skpatel6/Pelvic-Floor-Muscle-Biofeedback-Games/Documents/Progress Reports/BME_Weekly_Report_11-13.pdf

Pelvic floor Biofeedback Design

Client: Dr. Patrick McKenna, UW Urology Department

Advisor: Dr. Amit Nimunkar

Team: Sam Lines (Leader)

Michael Simonson (Communicator)

Shawn Patel (BWIG)

Andrew Vamos (BSAC&BPAG)

Date: 11/6/2014-11/14/2014

### Problem Statement

Pelvic floor muscle biofeedback systems have been used to educate and train people how to correctly control the process of urination in children and elderly patients. As devices slowly fail or get outdated, a new device and interface system that can be used in conjecture with videogame like training programs is desired. With the completion of a basic EMG biofeedback system, our goal is to continue to improve the functionality of the software while simultaneously designing hardware with commercial standards in mind. This product will be designed and tested so that use in a hospital will be safe for both the hospital staff and the patients.

### Last Week’s Goals

- Upon our final review of the PCB, we will order it along with the parts needed to start version two of the EMG system.
- We will continue to work on the IRB proposal to be able to submit it as soon as possible.
- Along with the IRB proposal submission, work in tandem with Dr. McKenna to ensure everyone has the proper training for human subject testing

### Summary of Team Role Accomplishments

- Leader (Sam): Finalized the PCB with Shawn
- Communicator (Michael): Continued IRB work
- BWIG (Shawn): Finalized the PCB with Sam
- BPAG And BSAC(Andrew): Began research into Arduino coding

### Summary of Design Accomplishments

- After running into an unforeseen problem with the PCB, we have now completed the PCB, and are reviewing it
- Due to the delay in the PCB, we plan to order the parts and PCB today or tomorrow.
- Andrew made some good progress into the Arduino coding research, and we believe it we will be able to quickly finalize version one of the EMG pending no further set backs

### Project Difficulties

- A last minute catch in the PCB made it so we had to push back the ordering of the PCB for a little over a week. Now that we have finished with the PCB, we will try to make up ground on neglected areas of the project
- Since we are a little behind again, we will have to work very diligently in the coming weeks to prevent costly mistakes. We hope to be testing our device before Thanksgiving break assuming the parts come in.

### This Week’s Goals

- After dealing with a PCB problem, we are ready to order that and the second parts list. •

### Activities

Person(s) | Task | Time (hrs) | Week Total | Semester Total
Sam | PCB work Team meeting | 2.5 2.5 | 5 | 33
Michael | IRB Team meeting | 2.5 2.5 | 5 | 33
Shawn | PCB Work Team meeting | 2.5 2.5 | 5 | 33
Andrew | Aduino Code Team meeting | 2.5 2.5 | 5 | 33

### Timetable

- Due to the large size of our timeline, I will attach the full excel spreadsheet

### Expenses

- After buying the parts, the current expense of the project is $41.22. A picture of the total expenses incurred is posted below.

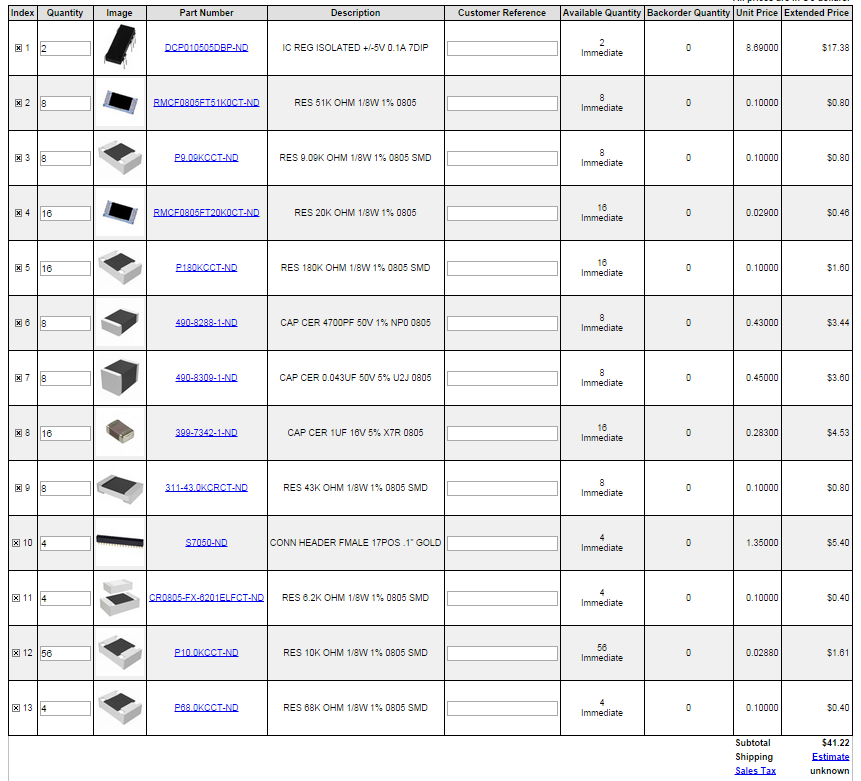
[picture p12: figure]
