skpatel6/Pelvic-Floor-Muscle-Biofeedback-Games/Documents/Progress Reports/BME_Weekly_Report_11-20.pdf

Pelvic floor Biofeedback Design

Client: Dr. Patrick McKenna, UW Urology Department

Advisor: Dr. Amit Nimunkar

Team: Sam Lines (Leader)

Michael Simonson (Communicator)

Shawn Patel (BWIG)

Andrew Vamos (BSAC&BPAG)

Date: 11/17/2014-11/21/2014

### Problem Statement

Pelvic floor muscle biofeedback systems have been used to educate and train people how to correctly control the process of urination in children and elderly patients. As devices slowly fail or get outdated, a new device and interface system that can be used in conjecture with videogame like training programs is desired. With the completion of a basic EMG biofeedback system, our goal is to continue to improve the functionality of the software while simultaneously designing hardware with commercial standards in mind. This product will be designed and tested so that use in a hospital will be safe for both the hospital staff and the patients.

### Last Week’s Goals

- Order the PCB and second round of parts
- We will continue to work on the IRB proposal to be able to submit it as soon as possible.
- Test the first round of parts to ensure that everything works properly

### Summary of Team Role Accomplishments

- Leader (Sam): Finalized the PCB with Shawn and tested first round of parts
- Communicator (Michael): Continued IRB work
- BWIG (Shawn): Finalized the PCB with Sam
- BPAG And BSAC(Andrew): continued research into Arduino coding

### Summary of Design Accomplishments

- We have ordered all of the parts that we will need to complete version one of our design and start working on version two.
- We continue to make progress on the IRB submission and we look forward to submitting it as soon as possible. Everyone in the group has taken the necessary CITI and HIPAA training.
- We have started to push the project from a design oriented phase to a more balanced phase in which we will make improvements on the design as well as pursuing formal documentation and possible submission to WARF.

### Project Difficulties

- Since we have ordered the parts and PCB, most of this week's work has involved working on the IRB submission and updating documents, and therefore we didn't run into any struggles worth reporting.

### This Week’s Goals

- While waiting for the second round of parts and the PCB, we will continue working on the IRB application
- We will start to make our documentation of the entire project more professional while waiting for the PCB
- Start working to implement the new microcontroller code, and test with our bread board EMGs
- Begin working on version two of the design which will be more suited to commercialization.

### Activities

Person(s) | Task | Time (hrs) | Week Total | Semester Total
Sam | PCB work Team meeting | 2.5 2.5 | 5 | 38
Michael | IRB Team meeting | 2.5 2.5 | 5 | 38
Shawn | PCB Work Team meeting | 2.5 2.5 | 5 | 38
Andrew | Aduino Code Team meeting | 2.5 2.5 | 5 | 38

### Timetable

- Due to the large size of our timeline, I will attach the full excel spreadsheet

### Expenses

- After buying the parts, the current expense of the project is $41.22. A picture of the total expenses incurred is posted below.
