skpatel6/Pelvic-Floor-Muscle-Biofeedback-Games/Documents/Progress Reports/BME_Weekly_Report_11-6.pdf

Pelvic floor Biofeedback Design

Client: Dr. Patrick McKenna, UW Urology Department

Advisor: Dr. Amit Nimunkar

Team: Sam Lines (Leader)

Michael Simonson (Communicator)

Shawn Patel (BWIG)

Andrew Vamos (BSAC&BPAG)

Date: 11/3/2014-11/6/2014

### Problem Statement

Pelvic floor muscle biofeedback systems have been used to educate and train people how to correctly control the process of urination in children and elderly patients. As devices slowly fail or get outdated, a new device and interface system that can be used in conjecture with videogame like training programs is desired. With the completion of a basic EMG biofeedback system, our goal is to continue to improve the functionality of the software while simultaneously designing hardware with commercial standards in mind. This product will be designed and tested so that use in a hospital will be safe for both the hospital staff and the patients.

### Last Week’s Goals

- Order the second set of parts that we forgot to order last time
- Finish the PCB and order that with the next parts
- Finish a testing protocol so that we can test the device as soon as it is made.

### Summary of Team Role Accomplishments

- Leader (Sam): Finalized the PCB with Shawn
- Communicator (Michael): Continued IRB work and finished work on lead fall off detection
- BWIG (Shawn): Finalized the PCB with Sam
- BPAG And BSAC(Andrew): Finished controllable gain work

### Summary of Design Accomplishments

- We have finished the PCB schematic and are ready to order it pending some final reviews and revisions
- We have decided to freeze our current work and pursue it as version one of the EMG system

- While we have frozen the design as is for version one, we have compiled a list of parts that will allow us to implement digitally controllable gain and lead fall off detection in version two.

### Project Difficulties

- With our research into controllable gain and lead off detection, we decided that in order to implement them into our first version it would significantly delay our ordering of the PCB.
- The remote access version of Altium provided through the university has limited libraries of parts provided, so it delayed our completion of the PCB a little more than we anticipated

### This Week’s Goals

- Upon our final review of the PCB, we will order it along with the parts needed to start version two of the EMG system.
- We will continue to work on the IRB proposal to be able to submit it as soon as possible.
- Along with the IRB proposal submission, work in tandem with Dr. McKenna to ensure everyone has the proper training for human subject testing

### Activities

Person(s) | Task | Time (hrs) | Week Total | Semester Total
Sam | PCB work Team meeting | 2 1 | 3 | 28
Michael | Lead fall off detection IRB Team meeting | 1 1 1 | 3 | 29
Shawn | PCB Work Team meeting | 2 1 | 3 | 28
Andrew | Controllable gain work Team meeting | 2 1 | 3 | 28

### Timetable

- Due to the large size of our timeline, I will attach the full excel spreadsheet

### Expenses

- After buying the parts, the current expense of the project is $41.22. A picture of the total expenses incurred is posted below.
