skpatel6/Pelvic-Floor-Muscle-Biofeedback-Games/Documents/Progress Reports/BME_Weekly_Report_10-30.pdf

Pelvic floor Biofeedback Design

Client: Dr. Patrick McKenna, UW Urology Department

Advisor: Dr. Amit Nimunkar

Team: Sam Lines (Leader)

Michael Simonson (Communicator)

Shawn Patel (BWIG)

Andrew Vamos (BSAC&BPAG)

Date: 10/27/2014-10/31/2014

### Problem Statement

Pelvic floor muscle biofeedback systems have been used to educate and train people how to correctly control the process of urination in children and elderly patients. As devices slowly fail or get outdated, a new device and interface system that can be used in conjecture with videogame like training programs is desired. With the completion of a basic EMG biofeedback system, our goal is to continue to improve the functionality of the software while simultaneously designing hardware with commercial standards in mind. This product will be designed and tested so that use in a hospital will be safe for both the hospital staff and the patients.

### Last Week’s Goals

- We have ordered the parts, so we will use the time for their delivery to finish the PCB and order that
- Begin working on the Arduino software to prepare to completion of the EMG circuit
- This software update will mainly consist of programmable gain control to help make the system more universal in patient treatment.

### Summary of Team Role Accomplishments

- Leader (Sam): Began work on the PCB schematic
- Communicator (Michael): Continued IRB work and started to work on lead fall off detection
- BWIG (Shawn): Implemented GitHub and started work on the gain control
- BPAG And BSAC(Andrew): Started working on microcontroller code formatting

### Summary of Design Accomplishments

- We have started to work on the PCB schematic and will have a first version finished early next week
- We forgot to order a few parts on our last order so we remade a list and will get that submitted as soon as we confirm we will have everything that we need.
- We will be meeting with Tina tomorrow to go over the IRB submission.

### Project Difficulties

- There have been some problems getting consistent power from the microcontroller so we will have to make our own USB port
- We have decided to incorporate lead fall off detection and controllable gain, so we will have to do some reading on how that can be coded into the Arduino.

### This Week’s Goals

- Order the second set of parts that we forgot to order last time
- Finish the PCB and order that with the next parts
- Finish a testing protocol so that we can test the device as soon as it is made.

### Activities

Person(s) | Task | Time (hrs) | Week Total | Semester Total
Sam | PCB work Team meeting | 2 1 | 3 | 25
Michael | Lead fall off detection Team meeting | 2 1 | 3 | 26
Shawn | Controllable gain Team meeting | 2 1 | 3 | 25
Andrew | Microcontroller coding work Team meeting | 2 1 | 3 | 25

### Timetable

- Due to the large size of our timeline, I will attach the full excel spreadsheet

### Expenses

- After buying the parts, the current expense of the project is $41.22. A picture of the total expenses incurred is posted below.
