skpatel6/Pelvic-Floor-Muscle-Biofeedback-Games/Documents/Progress Reports/BME_Weekly_Report_10-23.pdf

Pelvic floor Biofeedback Design

Client: Dr. Patrick McKenna, UW Urology Department

Advisor: Dr. Amit Nimunkar

Team: Sam Lines (Leader)

Michael Simonson (Communicator)

Shawn Patel (BWIG)

Andrew Vamos (BSAC&BPAG)

Date: 10/20/2014-10/25/2014

### Problem Statement

Pelvic floor muscle biofeedback systems have been used to educate and train people how to correctly control the process of urination in children and elderly patients. As devices slowly fail or get outdated, a new device and interface system that can be used in conjecture with videogame like training programs is desired. With the completion of a basic EMG biofeedback system, our goal is to continue to improve the functionality of the software while simultaneously designing hardware with commercial standards in mind. This product will be designed and tested so that use in a hospital will be safe for both the hospital staff and the patients.

### Last Week’s Goals

- Finalize our design on a printed circuit board hardware to order our PCB
- Look into the frequency characteristics of different muscle groups so that we can confirm that we are indeed measuring from the correct muscle groups
- Finalize testing protocols with Amit's guidance

### Summary of Team Role Accomplishments

- Leader (Sam): Communicated with professors of physiology and kinesiology to determine frequency characteristics of different muscles
- Communicator (Michael): Began contact with the IRB to prepare for clinical use
- BWIG (Shawn): Researched frequency characteristics of different muscles
- BPAG And BSAC(Andrew): Researched frequency characteristics of different muscles

### Summary of Design Accomplishments

- We have confirmed that the frequency components of the EMG signal will not help us differentiate signals from different muscles
- With that knowledge in mind, we ordered parts and will be working on ordering our pcb.
- Andrew found a paper describing the frequency changes at different levels of contraction that indicates it will be possible to use an envelope function to determine the amplitude of the signal, and then use that to play the game

### Project Difficulties

- In order to get the precision we wanted for our circuitry, we had to order surface mount components. Andrew has had some experience with this, so we don't believe it will be too much of an issue during construction
- Due to a grounding problem, we had a lot of 60hz noise in our circuit. With Dr. Nimunkar's help, we were able to elminate this problem.

### This Week’s Goals

- We have ordered the parts, so we will use the time for their delivery to finish the PCB and order that
- Begin working on the Arduino software to prepare to completion of the EMG circuit
- This software update will mainly consist of programmable gain control to help make the system more universal in patient treatment.

### Activities

Person(s) | Task | Time (hrs) | Week Total | Semester Total
Sam | Ordering parts Test grounding problem Research | 2 1 1 | 4 | 22
Michael | Ordering parts Test grounding problem Contact IRB | 2 1 1 | 4 | 23
Shawn | Ordering parts Test grounding problem Research | 2 1 1 | 4 | 22
Andrew | Ordering parts Test grounding problem Research | 2 1 1 | 4 | 22

### Timetable

- Due to the large size of our timeline, I will attach the full excel spreadsheet

### Expenses

- After buying the parts, the current expense of the project is $41.22. A picture of the total expenses incurred is posted below.
