skpatel6/Pelvic-Floor-Muscle-Biofeedback-Games/Circuit Schematics/Schematic.PNG

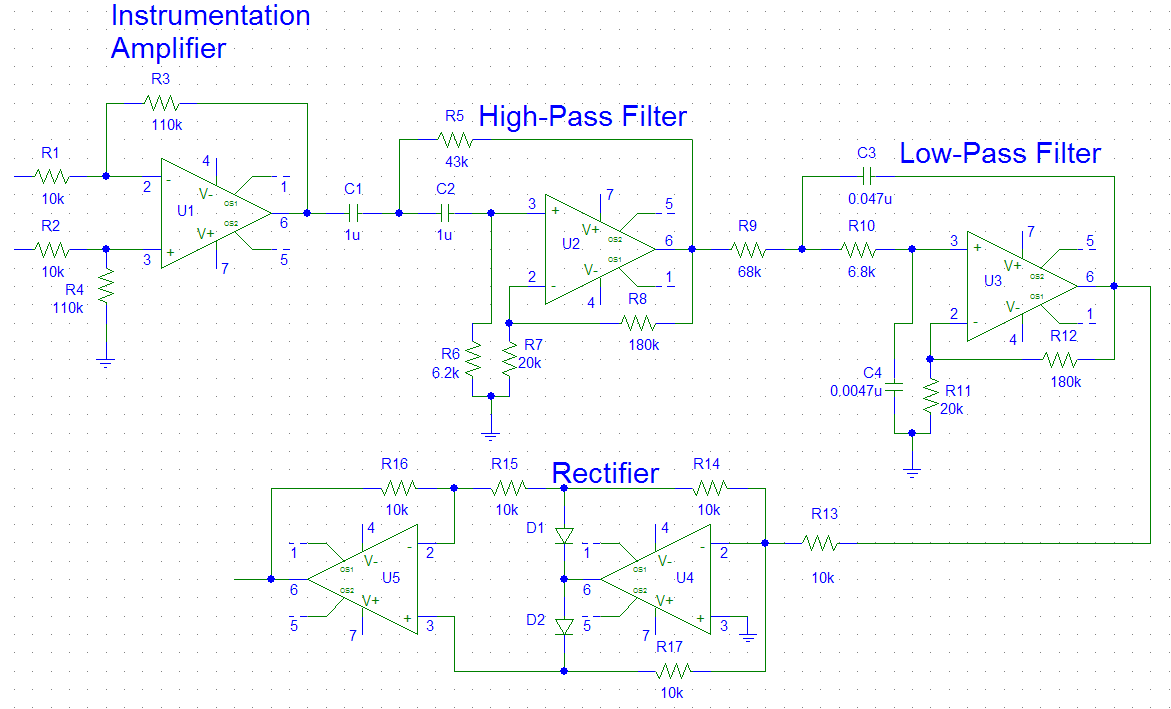
Circuit Schematics/Schematic.PNG
