skpatel6/Pelvic-Floor-Muscle-Biofeedback-Games/(list of files, drawings)

Other design files:
Circuit Schematics/EMG_biofedback.SchDoc
Circuit Schematics/EMG_biofeedback.PrjPcb
Circuit Schematics/EMG_Connections.SchDoc
Circuit Schematics/EMG_PCB.PcbDoc
