skpatel6/Pelvic-Floor-Muscle-Biofeedback-Games/(commit log)

2014-10-28 Initial upload of existing documents/files
    [Schematic1.sch, Schematic2.sch]
2014-11-04 Altium Schematics
    Altium Schematics
    [EMG_biofedback.SchDoc, EMG_biofeedback.PrjPcb]
2014-11-13 EMG Version 1
    Version 1 update
    [EMG_Connections.SchDoc, EMG_PCB.PcbDoc, EMG_biofedback.SchDoc, EMG_biofeedback.PrjPcb]
2014-12-03 Added PCB to block diagram
